austinjonathan1/EMS-for-StorageCells-in-EVs/Reports & Presentations/Midterm Report (EE 198B-01).docx

Midterm Report

By: Andrew Tran (012394096), Hiromi Saito (014065129), Jonathan Austin (012148162)

1. Accomplishments

a. Andrew:
  i. Revised the Bill of Materials for the Current Sense Module, to accommodate chip shortage
  ii. Helping Yun (a new member) get up to speed with OrCAD and basic knowledge of power module team
  iii. Assisted Hiromi in redesigning the PCB for the Current Sense Module
b. Hiromi:
  i. Resized the silkscreen layer to follow selected PCB manufacturer’s capabilities and to be practically visible
  ii. Readjusted pad connections on the high current components to be completely connected
  iii. Added via stitching to the larger planes on the current sense PCB to lower the impedance
  iv. Designated text boxes on the PCB file of the current sense to give viewers a better understanding of the different sections
  v. Removed/added inappropriate connections on the PCB file
c. Jonathan:
  i. Read through, watched video documentation, and presentations of the existing main DSP project work
  ii. Performed Lab Testing of existing DSP code on the existing hardware
  iii. Helped implement a matrix-based sorting algorithm from Professor Badawy’s paper, A Modular Multi-Level Converter for Energy Management of Hybrid Storage System in Electric Vehicles
    1. Wrote out the logic in a separate test code
    2. Helped integrate the logic into the existing main DSP code
  iv. Read through, watched video documentation, and presentations of the existing Linear Kalman Filter MATLAB work by Samuel

2. Plan

d. Andrew:
  i. Begin testing hardware once the PCB has been manufactured and assembled
  ii. Research how to use Altium for the next revision of the boards
  iii. Assist Yun for her upcoming work
e. Hiromi:
  i. Manufacture the current sense PCB and perform testing with the inverter PCB
    1. Record results and organize the data results into a report/presentation
  ii. Research how to use Altium
f. Jonathan:
  i. Continue understanding and researching the existing MATLAB work on the Linear Kalman Filter
  ii. Integrate it into Maryam’s Model Predictive Control MATLAB project
  iii. Document work in report and presentation

References

[1] S. S. George and M. O. Badawy, A Modular Multi-Level Converter for Energy Management of Hybrid Storage System in Electric Vehicles, 2018 IEEE Transportation Electrification Conference and Expo (ITEC), Long Beach, CA, USA, 2018, pp. 336-341, doi: 10.1109/ITEC.2018.8450237. Available at: <https://ieeexplore.ieee.org/abstract/document/8450237> [Accessed 14 March 2021].
