austinjonathan1/EMS-for-StorageCells-in-EVs/Reports & Presentations/SOC_Algorithm_Report.pdf

## SOC Algorithm Report

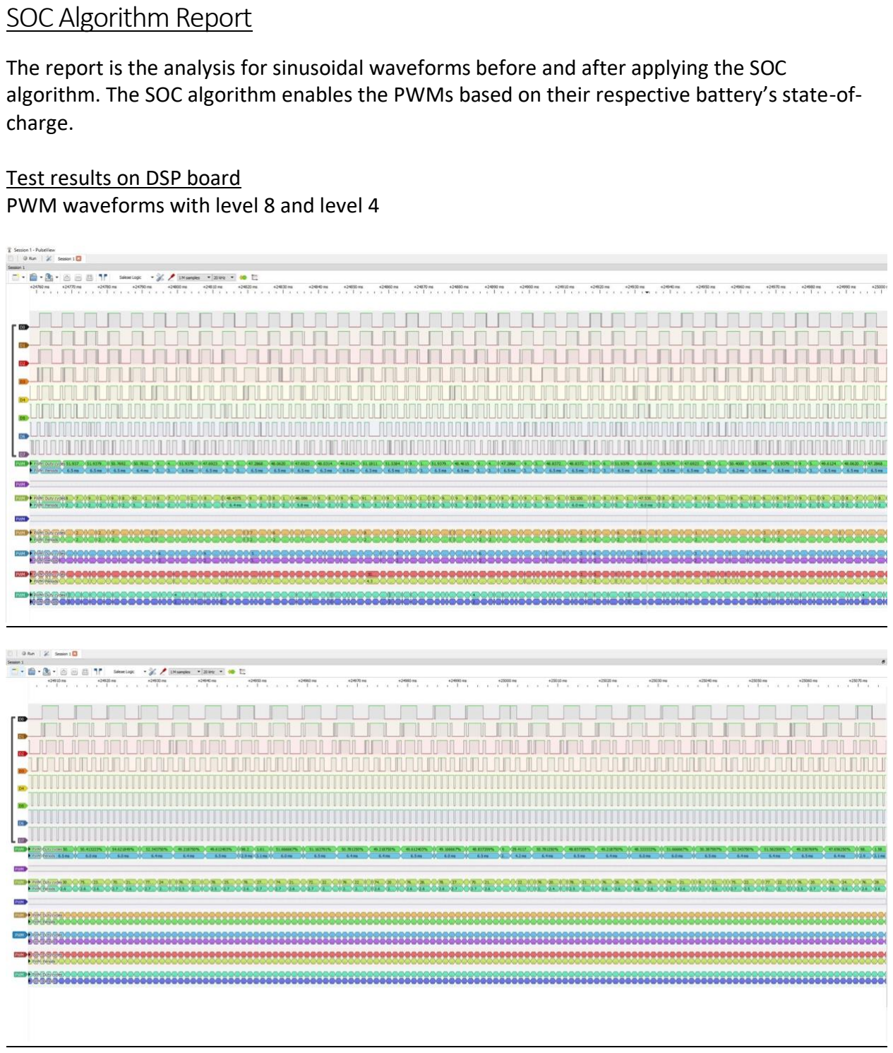
[picture p32: page 1]

The report is the analysis for sinusoidal waveforms before and after applying the SOC algorithm. The SOC algorithm enables the PWMs based on their respective battery’s state-ofcharge.

Test results on DSP board
PWM waveforms with level 8 and level 4

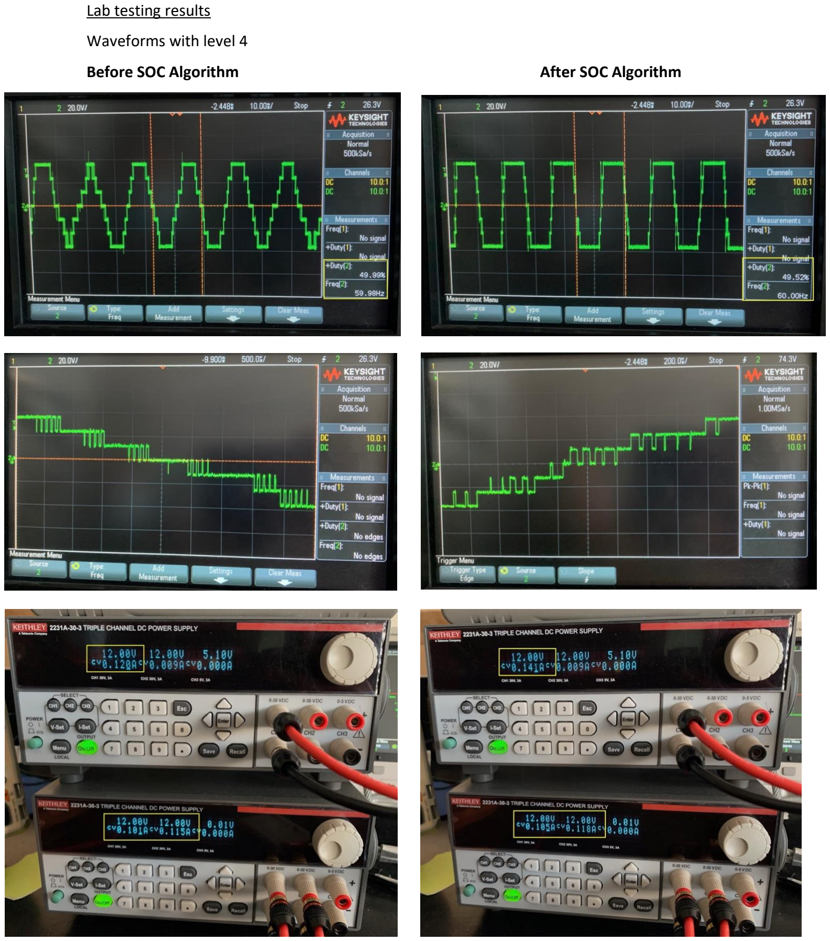
[picture p33: page 2]

Lab testing results

Waveforms with level 4

Before SOC Algorithm | After SOC Algorithm

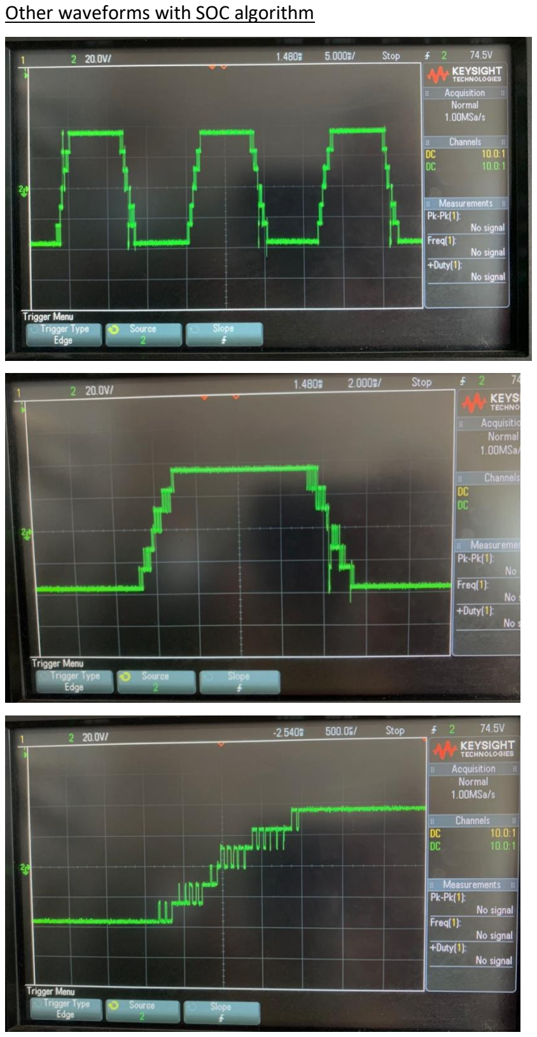
[picture p34: page 3]

Other waveforms with SOC algorithm

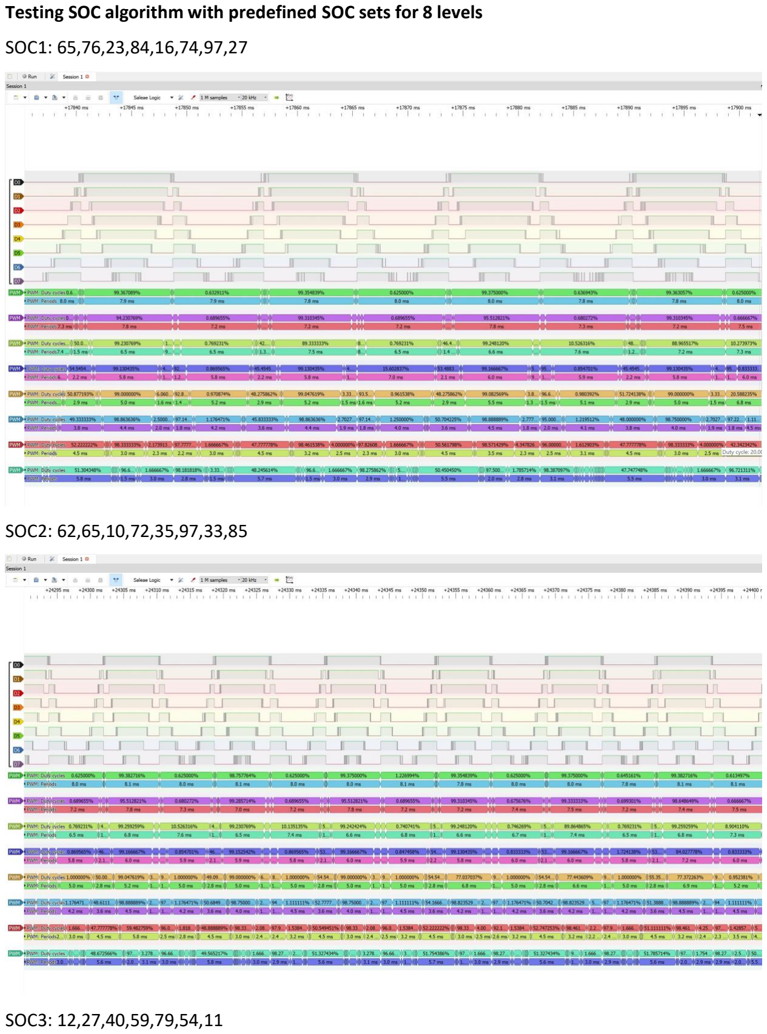
[picture p35: page 4]

Testing SOC algorithm with predefined SOC sets for 8 levels

SOC1: 65,76,23,84,16,74,97,27

SOC2: 62,65,10,72,35,97,33,85

SOC3: 12,27,40,59,79,54,11

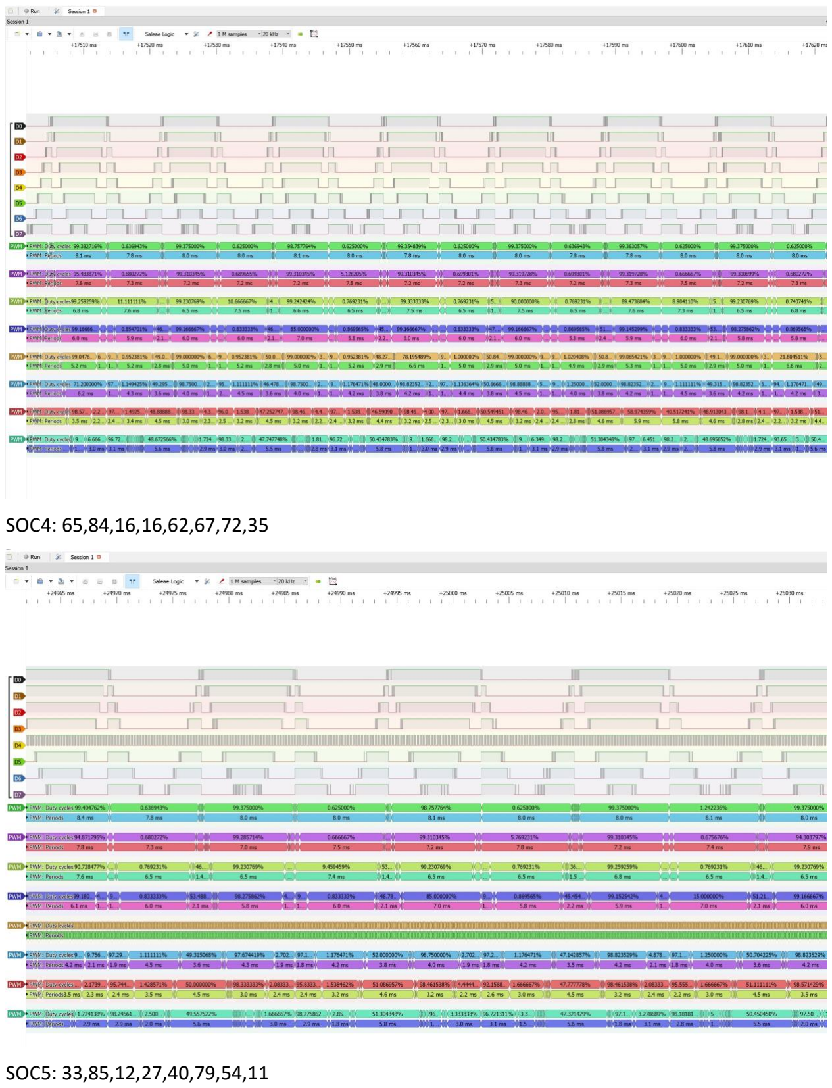
[picture p36: page 5]

SOC4: 65,84,16,16,62,67,72,35

SOC5: 33,85,12,27,40,79,54,11

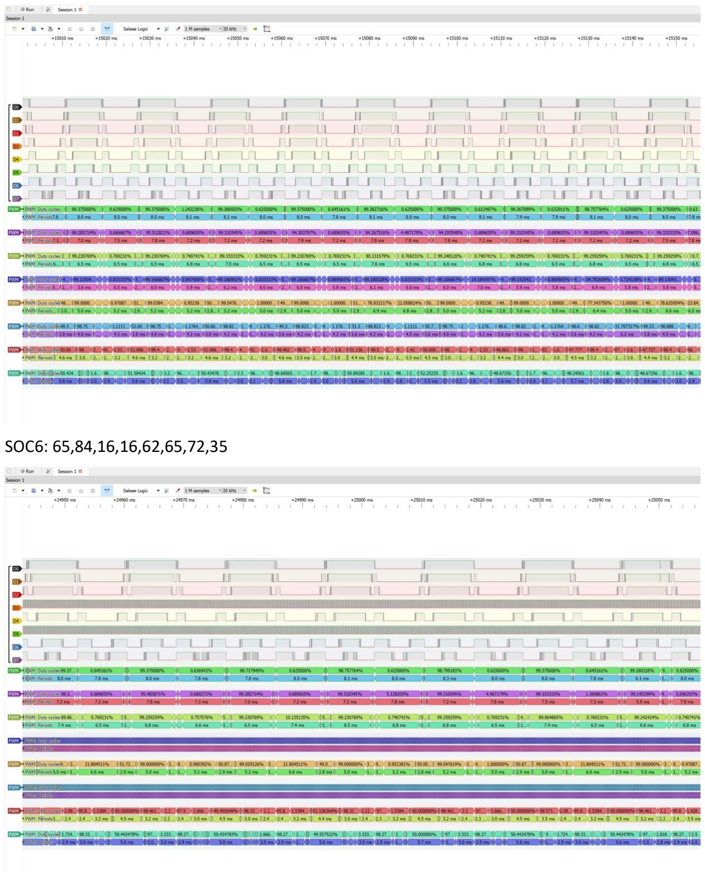
[picture p37: page 6]

SOC6: 65,84,16,16,62,65,72,35
