austinjonathan1/EMS-for-StorageCells-in-EVs/Reports & Presentations/EE198A Presentation Work Schedule (EE 198A-01).xlsx

Team | Member | Task | June |  |  |  |  | July
 |  |  | 2021-06-02 | 2021-06-09 | 2021-06-16 | 2021-06-23 | 2021-06-30 | 2021-07-05 | 2021-07-12 | 2021-07-19 | 2021-07-26
Embedded Systems (ES) | Jonathan | Finish Implementing and Testing SOC Sorting Algorithm
 |  | Write SOC Estimation Algorithm
Power Module Design (PMD) | Andrew | Learn Ansys
 | Hiromi | Redesign VIAs and footprints for Current Sense
 | Andrew & Hiromi | Learn more about designing PCBs on OrCad
 |  | Finish Current Sense PCB Board
