austinjonathan1/EMS-for-StorageCells-in-EVs/Reports & Presentations/Meeting Log File (EE 198A-01).xlsx

NOTE: All meetings lasted from 5:30 PM to 6:15PM
Team | 2021-02-01 | 2021-02-08 | 2021-02-15 | 2021-02-22 | 2021-03-01 | 2021-03-08 | 2021-03-15 | 2021-03-22 | 2021-03-29 | 2021-04-05 | 2021-04-12 | 2021-04-19 | 2021-04-26 | 2021-05-03 | 2021-05-10 | 2021-05-17
Embedded System (Jonathan Austin) | Research and learning (Badawy gave resources and content to read to understand the system) |  |  |  | Testing and validating existing code (presented results and planned further work at meetings) |  |  |  |  | Wrote, tested, and implemented code (presented results and consulted past members) |  |  |  | Badawy had family emergency so not a lot was done here besides creating presentations and writing reports
Power Module Design (Andrew Tran & Hiromi Saito) | Research and learning about the current system |  |  |  | Discussed the issues about different ground reference points came up with possible solutions |  | Finish designing current sense module and start using real components for simulation |  | Finalize current sense design Begin learning how to make a PCB | Presented current sense module schematic and simulation results Began working on PCB |  |  |  | Badawy had family emergency so not a lot was done here besides creating presentations and writing reports
