austinjonathan1/EMS-for-StorageCells-in-EVs/Reports & Presentations/Meeting Log File (EE 198B-01).xlsx

NOTE: All meetings lasted from 5:30 PM to 6:15PM
Spring 2021
Team | 2021-02-01 | 2021-02-08 | 2021-02-15 | 2021-02-22 | 2021-03-01 | 2021-03-08 | 2021-03-15 | 2021-03-22 | 2021-03-29 | 2021-04-05 | 2021-04-12 | 2021-04-19 | 2021-04-26 | 2021-05-03 | 2021-05-10 | 2021-05-17
Embedded System (Jonathan Austin) | Research and learning (Badawy gave resources and content to read to understand the system) |  |  |  | Testing and validating existing code (presented results and planned further work at meetings) |  |  |  |  | Wrote, tested, and implemented code (presented results and consulted past members) |  |  |  | Badawy had family emergency so not a lot was done here besides creating presentations and writing reports
Power Module Design (Andrew Tran & Hiromi Saito) | Research and learning about the current system |  |  |  | Discussed the issues about different ground reference points came up with possible solutions |  | Finish designing current sense module and start using real components for simulation |  | Finalize current sense design Begin learning how to make a PCB | Presented current sense module schematic and simulation results Began working on PCB |  |  |  | Badawy had family emergency so not a lot was done here besides creating presentations and writing reports
Fall 2021
Team | 2021-08-30 | 2021-09-06 | 2021-09-13 | 2021-09-20 | 2021-09-27 | 2021-10-04 | 2021-10-11 | 2021-10-18 | 2021-10-25 | 2021-11-01 | 2021-11-08 | 2021-11-15 | 2021-11-22 | 2021-11-29 | 2021-12-06
Embedded System (Jonathan Austin) | Finished up testing and tasks from pior semester |  | Research and learning (Badawy gave resources and content to read to understand the system) |  |  | Wrote and tested code (Based off academia and prior simulation work) |  |  |  | Lab testing (with implemented code) |  |  | Discussion with Badawy regarding report, presentation, and symposium poster
Power Module Design (Andrew Tran & Hiromi Saito) | Look over designs and figure out which components are out of stock and need to be replaced. |  |  | Re-simulate with new components and compare with the previous results to see if any design changes are necessary. |  | Redesign PCB, adjusting footprints, rerouting traces for manufacturing capabilities |  |  |  |  | Generate Gerbers to get quotes for board design and fixing any issues if necessary.
