austinjonathan1/EMS-for-StorageCells-in-EVs/(list of files, cad)

Other CAD files:
Optimized_MMC_PWM/Debug/custom_drivers/adc_ISR.obj
Optimized_MMC_PWM/Debug/driverlib/can.obj
Optimized_MMC_PWM/Debug/custom_drivers/adc_input.obj
Optimized_MMC_PWM/Debug/driverlib/memcfg.obj
Optimized_MMC_PWM/Debug/custom_drivers/pwm_driver.obj
Optimized_MMC_PWM/Debug/driverlib/cmpss.obj
Optimized_MMC_PWM/Debug/custom_drivers/optimized_pwm_driver.obj
Optimized_MMC_PWM/Debug/driverlib/cla.obj
Optimized_MMC_PWM/Debug/custom_drivers/adc_driver.obj
Optimized_MMC_PWM/Debug/driverlib/dac.obj
Optimized_MMC_PWM/Debug/driverlib/i2c.obj
Optimized_MMC_PWM/Debug/driverlib/hrpwm.obj
Optimized_MMC_PWM/Debug/driverlib/eqep.obj
Optimized_MMC_PWM/Debug/driverlib/emif.obj
Optimized_MMC_PWM/Debug/driverlib/dma.obj
Optimized_MMC_PWM/Debug/driverlib/interrupt.obj
Optimized_MMC_PWM/Debug/driverlib/cputimer.obj
Optimized_MMC_PWM/Debug/driverlib/ecap.obj
Optimized_MMC_PWM/Debug/driverlib/asysctl.obj
Optimized_MMC_PWM/Debug/driverlib/adc.obj
Optimized_MMC_PWM/Debug/driverlib/mcbsp.obj
Optimized_MMC_PWM/Debug/driverlib/gpio.obj
Optimized_MMC_PWM/Debug/driverlib/epwm.obj
Optimized_MMC_PWM/Debug/driverlib/dcsm.obj
Optimized_MMC_PWM/Debug/driverlib/flash.obj
