austinjonathan1/EMS-for-StorageCells-in-EVs/MMC DSP Interface/MMC_DSP_interface.brd

## EAGLE design MMC DSP Interface/MMC_DSP_interface.brd (2023-10-27)

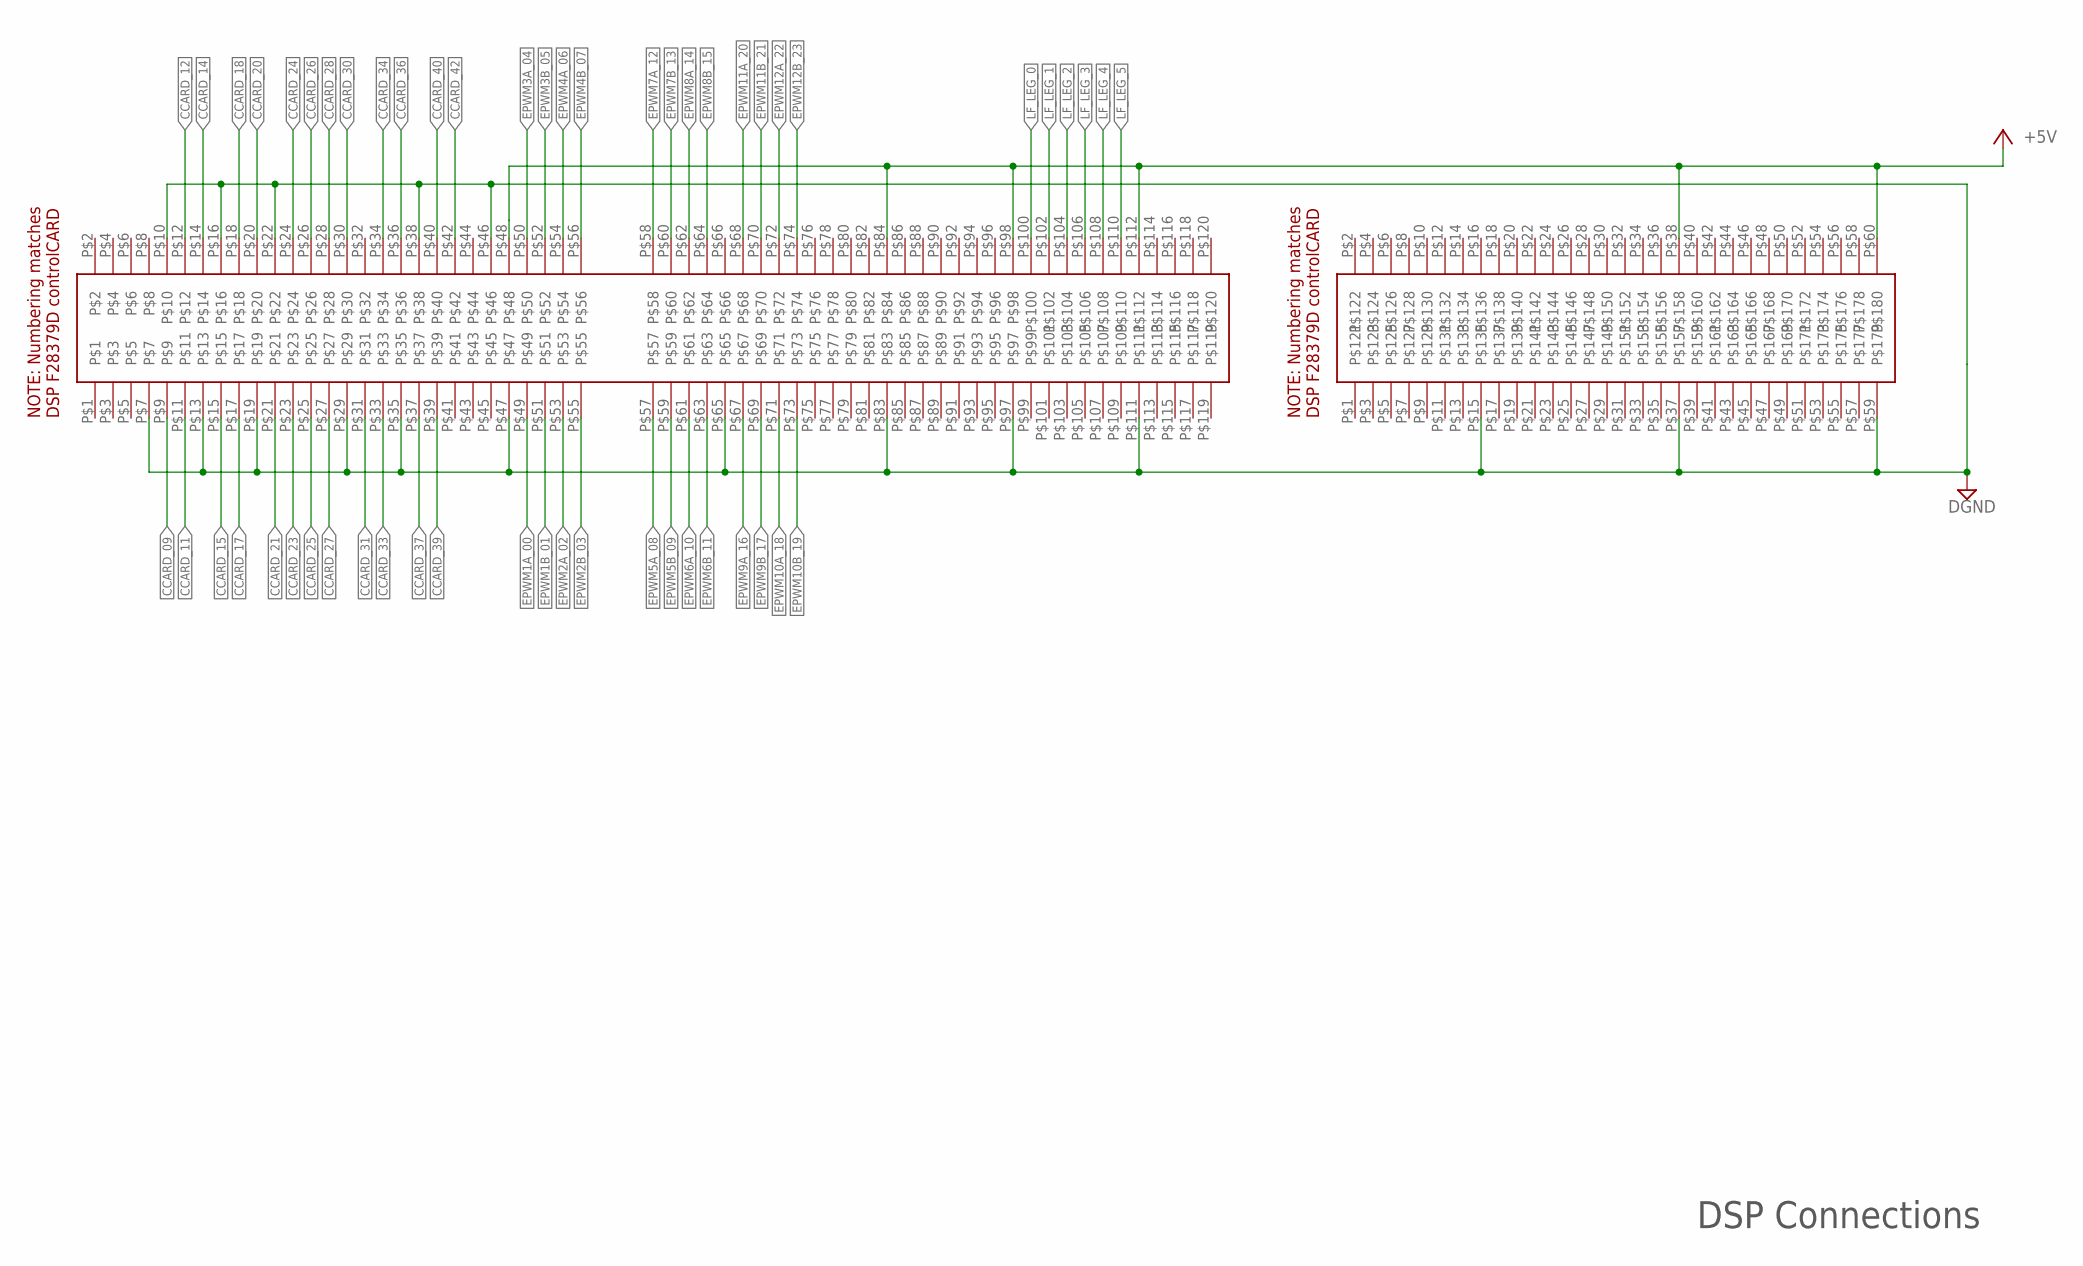
[picture p38: schematic MMC_DSP_interface.sch, sheet 1, DSP Connections]

Parts:
U$1: HSEC8-160-01-L-DV-A-BL
U$2: HSEC8-130-01-SM-DV-A

Connections:
+5V: U$1.P$48, U$1.P$84, U$1.P$98, U$1.P$112, U$2.P$38, U$2.P$60; also elsewhere on the board
CCARD_09: U$1.P$9; also elsewhere on the board
CCARD_11: U$1.P$11; also elsewhere on the board
CCARD_12: U$1.P$12; also elsewhere on the board
CCARD_14: U$1.P$14; also elsewhere on the board
CCARD_15: U$1.P$15; also elsewhere on the board
CCARD_17: U$1.P$17; also elsewhere on the board
CCARD_18: U$1.P$18; also elsewhere on the board
CCARD_20: U$1.P$20; also elsewhere on the board
CCARD_21: U$1.P$21; also elsewhere on the board
CCARD_23: U$1.P$23; also elsewhere on the board
CCARD_24: U$1.P$24; also elsewhere on the board
CCARD_25: U$1.P$25; also elsewhere on the board
CCARD_26: U$1.P$26; also elsewhere on the board
CCARD_27: U$1.P$27; also elsewhere on the board
CCARD_28: U$1.P$28; also elsewhere on the board
CCARD_30: U$1.P$30; also elsewhere on the board
CCARD_31: U$1.P$31; also elsewhere on the board
CCARD_33: U$1.P$33; also elsewhere on the board
CCARD_34: U$1.P$34; also elsewhere on the board
CCARD_36: U$1.P$36; also elsewhere on the board
CCARD_37: U$1.P$37; also elsewhere on the board
CCARD_39: U$1.P$39; also elsewhere on the board
CCARD_40: U$1.P$40; also elsewhere on the board
CCARD_42: U$1.P$42; also elsewhere on the board
DGND: U$1.P$7, U$1.P$10, U$1.P$13, U$1.P$16, U$1.P$19, U$1.P$22, U$1.P$29, U$1.P$35, U$1.P$38, U$1.P$46, U$1.P$47, U$1.P$65, U$1.P$83, U$1.P$97, U$1.P$111, U$2.P$15, U$2.P$37, U$2.P$59; also elsewhere on the board
EPWM1A_00: U$1.P$49; also elsewhere on the board
EPWM1B_01: U$1.P$51; also elsewhere on the board
EPWM2A_02: U$1.P$53; also elsewhere on the board
EPWM2B_03: U$1.P$55; also elsewhere on the board
EPWM3A_04: U$1.P$50; also elsewhere on the board
EPWM3B_05: U$1.P$52; also elsewhere on the board
EPWM4A_06: U$1.P$54; also elsewhere on the board
EPWM4B_07: U$1.P$56; also elsewhere on the board
EPWM5A_08: U$1.P$57; also elsewhere on the board
EPWM5B_09: U$1.P$59; also elsewhere on the board
EPWM6A_10: U$1.P$61; also elsewhere on the board
EPWM6B_11: U$1.P$63; also elsewhere on the board
EPWM7A_12: U$1.P$58; also elsewhere on the board
EPWM7B_13: U$1.P$60; also elsewhere on the board
EPWM8A_14: U$1.P$62; also elsewhere on the board
EPWM8B_15: U$1.P$64; also elsewhere on the board
EPWM9A_16: U$1.P$67; also elsewhere on the board
EPWM9B_17: U$1.P$69; also elsewhere on the board
EPWM10A_18: U$1.P$71; also elsewhere on the board
EPWM10B_19: U$1.P$73; also elsewhere on the board
EPWM11A_20: U$1.P$68; also elsewhere on the board
EPWM11B_21: U$1.P$70; also elsewhere on the board
EPWM12A_22: U$1.P$72; also elsewhere on the board
EPWM12B_23: U$1.P$74; also elsewhere on the board
LF_LEG_0: U$1.P$100; also elsewhere on the board
LF_LEG_1: U$1.P$102; also elsewhere on the board
LF_LEG_2: U$1.P$104; also elsewhere on the board
LF_LEG_3: U$1.P$106; also elsewhere on the board
LF_LEG_4: U$1.P$108; also elsewhere on the board
LF_LEG_5: U$1.P$110; also elsewhere on the board

Notes on the sheet:
DSP Connections

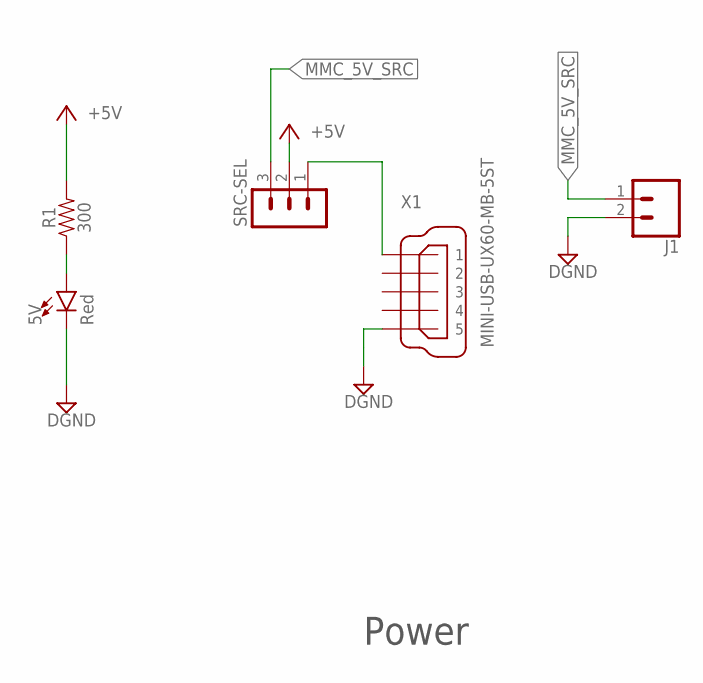
[picture p39: schematic MMC_DSP_interface.sch, sheet 2, Power]

Parts:
5V: Red; LED-0603
J1: CONN_02; 1X02
R1: 300; 0603
SRC-SEL: MA03-1
X1: MINI-USB-UX60-MB-5ST; UX60-MB-5ST

Connections:
+5V: R1.2, SRC-SEL.2; also elsewhere on the board
DGND: 5V.C, J1.2, X1.5; also elsewhere on the board
MMC_5V_SRC: J1.1, SRC-SEL.3
unnamed: SRC-SEL.1, X1.1
unnamed: 5V.A, R1.1

Notes on the sheet:
Power

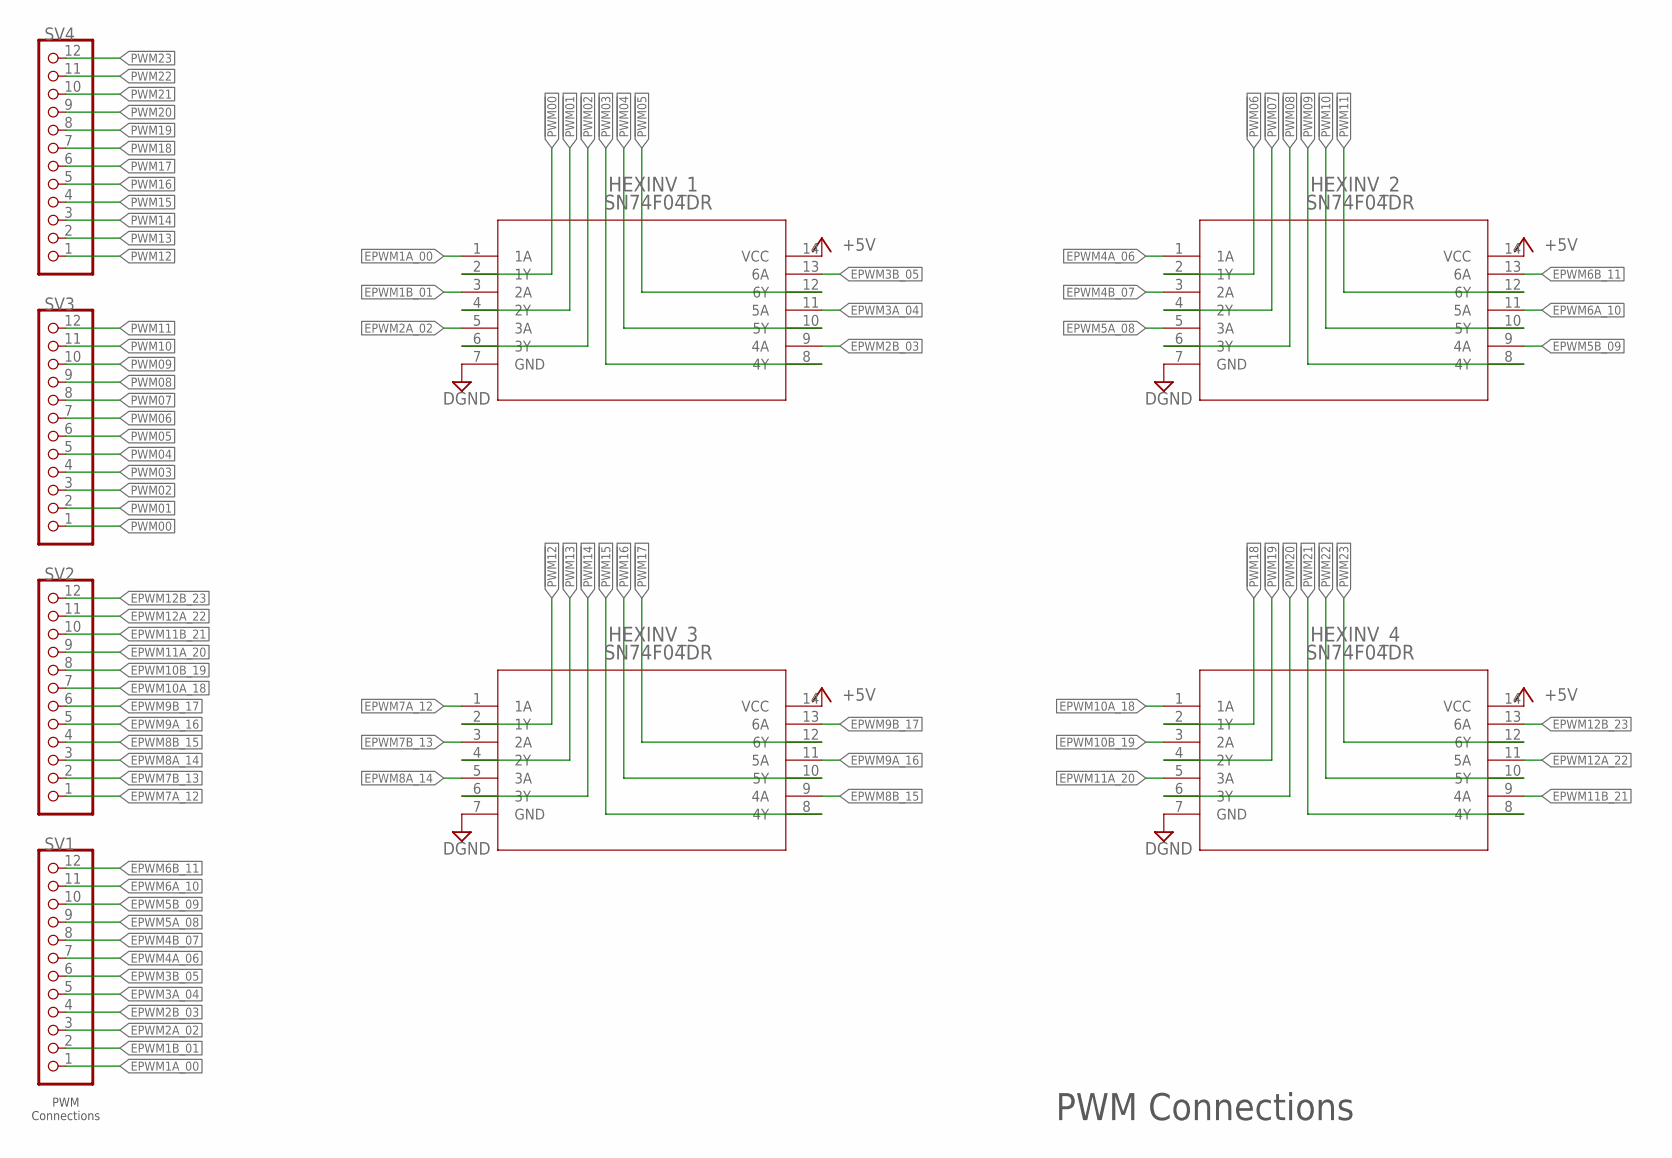
[picture p40: schematic MMC_DSP_interface.sch, sheet 3, PWM Connections]

Parts:
HEXINV_1, HEXINV_2, HEXINV_3, HEXINV_4: SN74F04DR; D14
SV1, SV2, SV3, SV4: PINHD-1X12-CB; 1X12-CB

Connections:
!PWM00: HEXINV_1.2 (1Y), SV3.1
!PWM01: HEXINV_1.4 (2Y), SV3.2
!PWM02: HEXINV_1.6 (3Y), SV3.3
!PWM03: HEXINV_1.8 (4Y), SV3.4
!PWM04: HEXINV_1.10 (5Y), SV3.5
!PWM05: HEXINV_1.12 (6Y), SV3.6
!PWM06: HEXINV_2.2 (1Y), SV3.7
!PWM07: HEXINV_2.4 (2Y), SV3.8
!PWM08: HEXINV_2.6 (3Y), SV3.9
!PWM09: HEXINV_2.8 (4Y), SV3.10
!PWM10: HEXINV_2.10 (5Y), SV3.11
!PWM11: HEXINV_2.12 (6Y), SV3.12
!PWM12: HEXINV_3.2 (1Y), SV4.1
!PWM13: HEXINV_3.4 (2Y), SV4.2
!PWM14: HEXINV_3.6 (3Y), SV4.3
!PWM15: HEXINV_3.8 (4Y), SV4.4
!PWM16: HEXINV_3.10 (5Y), SV4.5
!PWM17: HEXINV_3.12 (6Y), SV4.6
!PWM18: HEXINV_4.2 (1Y), SV4.7
!PWM19: HEXINV_4.4 (2Y), SV4.8
!PWM20: HEXINV_4.6 (3Y), SV4.9
!PWM21: HEXINV_4.8 (4Y), SV4.10
!PWM22: HEXINV_4.10 (5Y), SV4.11
!PWM23: HEXINV_4.12 (6Y), SV4.12
+5V: HEXINV_1.14 (VCC), HEXINV_2.14 (VCC), HEXINV_3.14 (VCC), HEXINV_4.14 (VCC); also elsewhere on the board
DGND: HEXINV_1.7 (GND), HEXINV_2.7 (GND), HEXINV_3.7 (GND), HEXINV_4.7 (GND); also elsewhere on the board
EPWM1A_00: HEXINV_1.1 (1A), SV1.1; also elsewhere on the board
EPWM1B_01: HEXINV_1.3 (2A), SV1.2; also elsewhere on the board
EPWM2A_02: HEXINV_1.5 (3A), SV1.3; also elsewhere on the board
EPWM2B_03: HEXINV_1.9 (4A), SV1.4; also elsewhere on the board
EPWM3A_04: HEXINV_1.11 (5A), SV1.5; also elsewhere on the board
EPWM3B_05: HEXINV_1.13 (6A), SV1.6; also elsewhere on the board
EPWM4A_06: HEXINV_2.1 (1A), SV1.7; also elsewhere on the board
EPWM4B_07: HEXINV_2.3 (2A), SV1.8; also elsewhere on the board
EPWM5A_08: HEXINV_2.5 (3A), SV1.9; also elsewhere on the board
EPWM5B_09: HEXINV_2.9 (4A), SV1.10; also elsewhere on the board
EPWM6A_10: HEXINV_2.11 (5A), SV1.11; also elsewhere on the board
EPWM6B_11: HEXINV_2.13 (6A), SV1.12; also elsewhere on the board
EPWM7A_12: HEXINV_3.1 (1A), SV2.1; also elsewhere on the board
EPWM7B_13: HEXINV_3.3 (2A), SV2.2; also elsewhere on the board
EPWM8A_14: HEXINV_3.5 (3A), SV2.3; also elsewhere on the board
EPWM8B_15: HEXINV_3.9 (4A), SV2.4; also elsewhere on the board
EPWM9A_16: HEXINV_3.11 (5A), SV2.5; also elsewhere on the board
EPWM9B_17: HEXINV_3.13 (6A), SV2.6; also elsewhere on the board
EPWM10A_18: HEXINV_4.1 (1A), SV2.7; also elsewhere on the board
EPWM10B_19: HEXINV_4.3 (2A), SV2.8; also elsewhere on the board
EPWM11A_20: HEXINV_4.5 (3A), SV2.9; also elsewhere on the board
EPWM11B_21: HEXINV_4.9 (4A), SV2.10; also elsewhere on the board
EPWM12A_22: HEXINV_4.11 (5A), SV2.11; also elsewhere on the board
EPWM12B_23: HEXINV_4.13 (6A), SV2.12; also elsewhere on the board

Notes on the sheet:
PWM Connections
PWM Connections

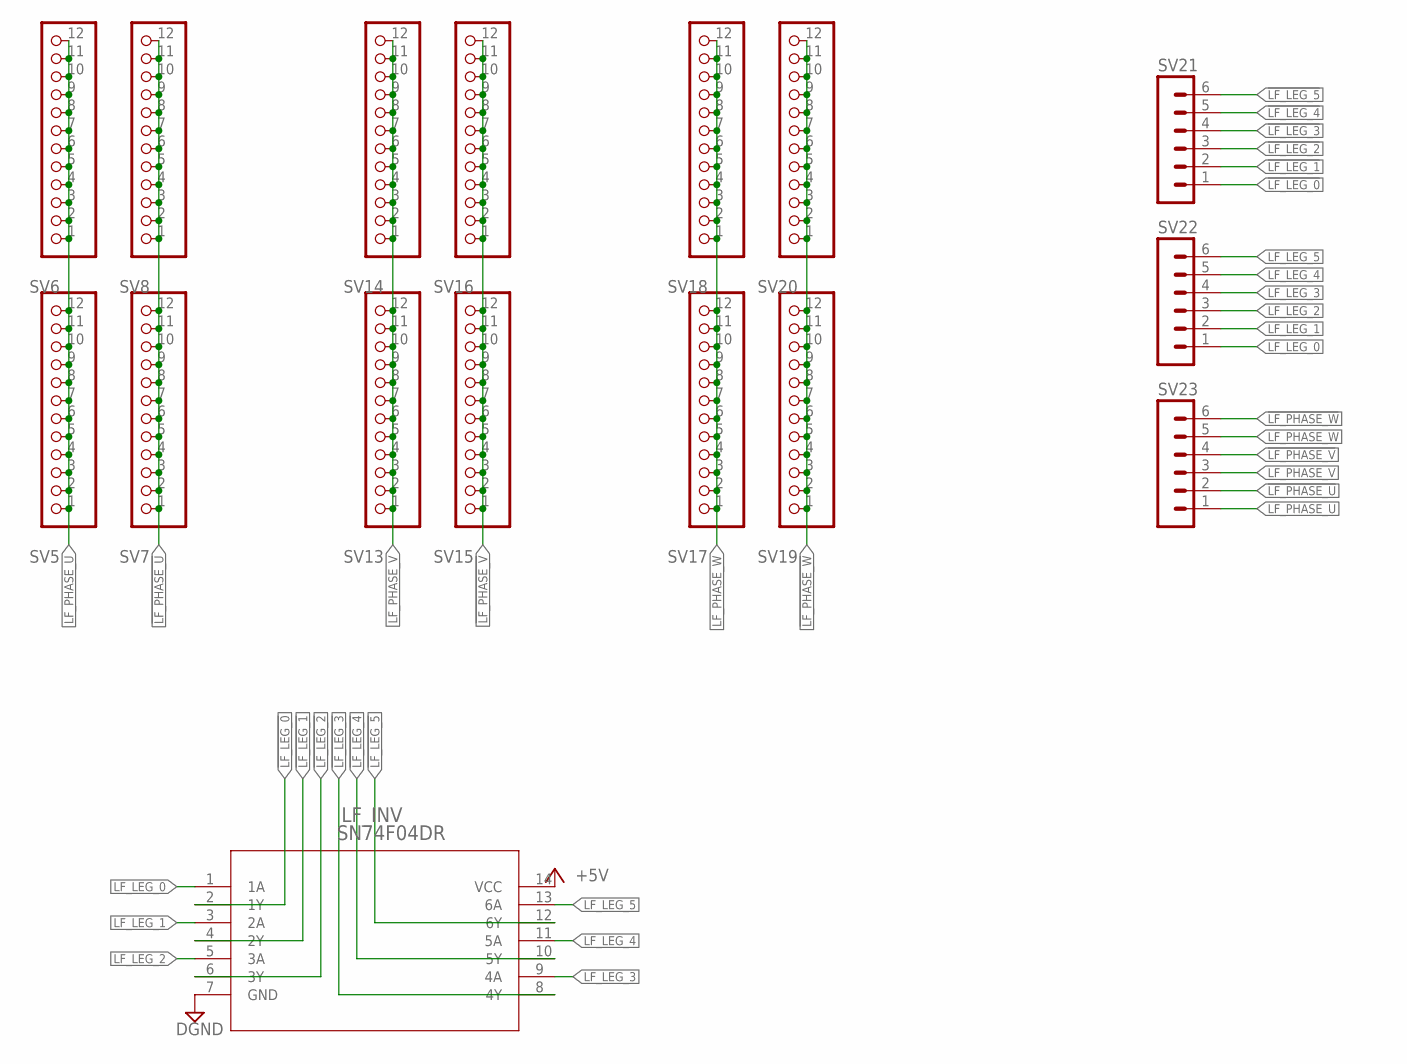
[picture p41: schematic MMC_DSP_interface.sch, sheet 4, GPIO NOT gates]

Parts:
LF_INV: SN74F04DR; D14
SV5, SV6, SV7, SV8, SV13, SV14, SV15, SV16, SV17, SV18, SV19, SV20: PINHD-1X12-CB; 1X12-CB
SV21, SV22, SV23: MA06-1

Connections:
!LF_LEG_0: LF_INV.2 (1Y), SV21.1
!LF_LEG_1: LF_INV.4 (2Y), SV21.2
!LF_LEG_2: LF_INV.6 (3Y), SV21.3
!LF_LEG_3: LF_INV.8 (4Y), SV21.4
!LF_LEG_4: LF_INV.10 (5Y), SV21.5
!LF_LEG_5: LF_INV.12 (6Y), SV21.6
!LF_PHASE_U: SV7.1, SV7.2, SV7.3, SV7.4, SV7.5, SV7.6, SV7.7, SV7.8, SV7.9, SV7.10, SV7.11, SV7.12, SV8.1, SV8.2, SV8.3, SV8.4, SV8.5, SV8.6, SV8.7, SV8.8, SV8.9, SV8.10, SV8.11, SV8.12, SV23.2
!LF_PHASE_V: SV15.1, SV15.2, SV15.3, SV15.4, SV15.5, SV15.6, SV15.7, SV15.8, SV15.9, SV15.10, SV15.11, SV15.12, SV16.1, SV16.2, SV16.3, SV16.4, SV16.5, SV16.6, SV16.7, SV16.8, SV16.9, SV16.10, SV16.11, SV16.12, SV23.4
!LF_PHASE_W: SV19.1, SV19.2, SV19.3, SV19.4, SV19.5, SV19.6, SV19.7, SV19.8, SV19.9, SV19.10, SV19.11, SV19.12, SV20.1, SV20.2, SV20.3, SV20.4, SV20.5, SV20.6, SV20.7, SV20.8, SV20.9, SV20.10, SV20.11, SV20.12, SV23.6
+5V: LF_INV.14 (VCC); also elsewhere on the board
DGND: LF_INV.7 (GND); also elsewhere on the board
LF_LEG_0: LF_INV.1 (1A), SV22.1; also elsewhere on the board
LF_LEG_1: LF_INV.3 (2A), SV22.2; also elsewhere on the board
LF_LEG_2: LF_INV.5 (3A), SV22.3; also elsewhere on the board
LF_LEG_3: LF_INV.9 (4A), SV22.4; also elsewhere on the board
LF_LEG_4: LF_INV.11 (5A), SV22.5; also elsewhere on the board
LF_LEG_5: LF_INV.13 (6A), SV22.6; also elsewhere on the board
LF_PHASE_U: SV5.1, SV5.2, SV5.3, SV5.4, SV5.5, SV5.6, SV5.7, SV5.8, SV5.9, SV5.10, SV5.11, SV5.12, SV6.1, SV6.2, SV6.3, SV6.4, SV6.5, SV6.6, SV6.7, SV6.8, SV6.9, SV6.10, SV6.11, SV6.12, SV23.1
LF_PHASE_V: SV13.1, SV13.2, SV13.3, SV13.4, SV13.5, SV13.6, SV13.7, SV13.8, SV13.9, SV13.10, SV13.11, SV13.12, SV14.1, SV14.2, SV14.3, SV14.4, SV14.5, SV14.6, SV14.7, SV14.8, SV14.9, SV14.10, SV14.11, SV14.12, SV23.3
LF_PHASE_W: SV17.1, SV17.2, SV17.3, SV17.4, SV17.5, SV17.6, SV17.7, SV17.8, SV17.9, SV17.10, SV17.11, SV17.12, SV18.1, SV18.2, SV18.3, SV18.4, SV18.5, SV18.6, SV18.7, SV18.8, SV18.9, SV18.10, SV18.11, SV18.12, SV23.5

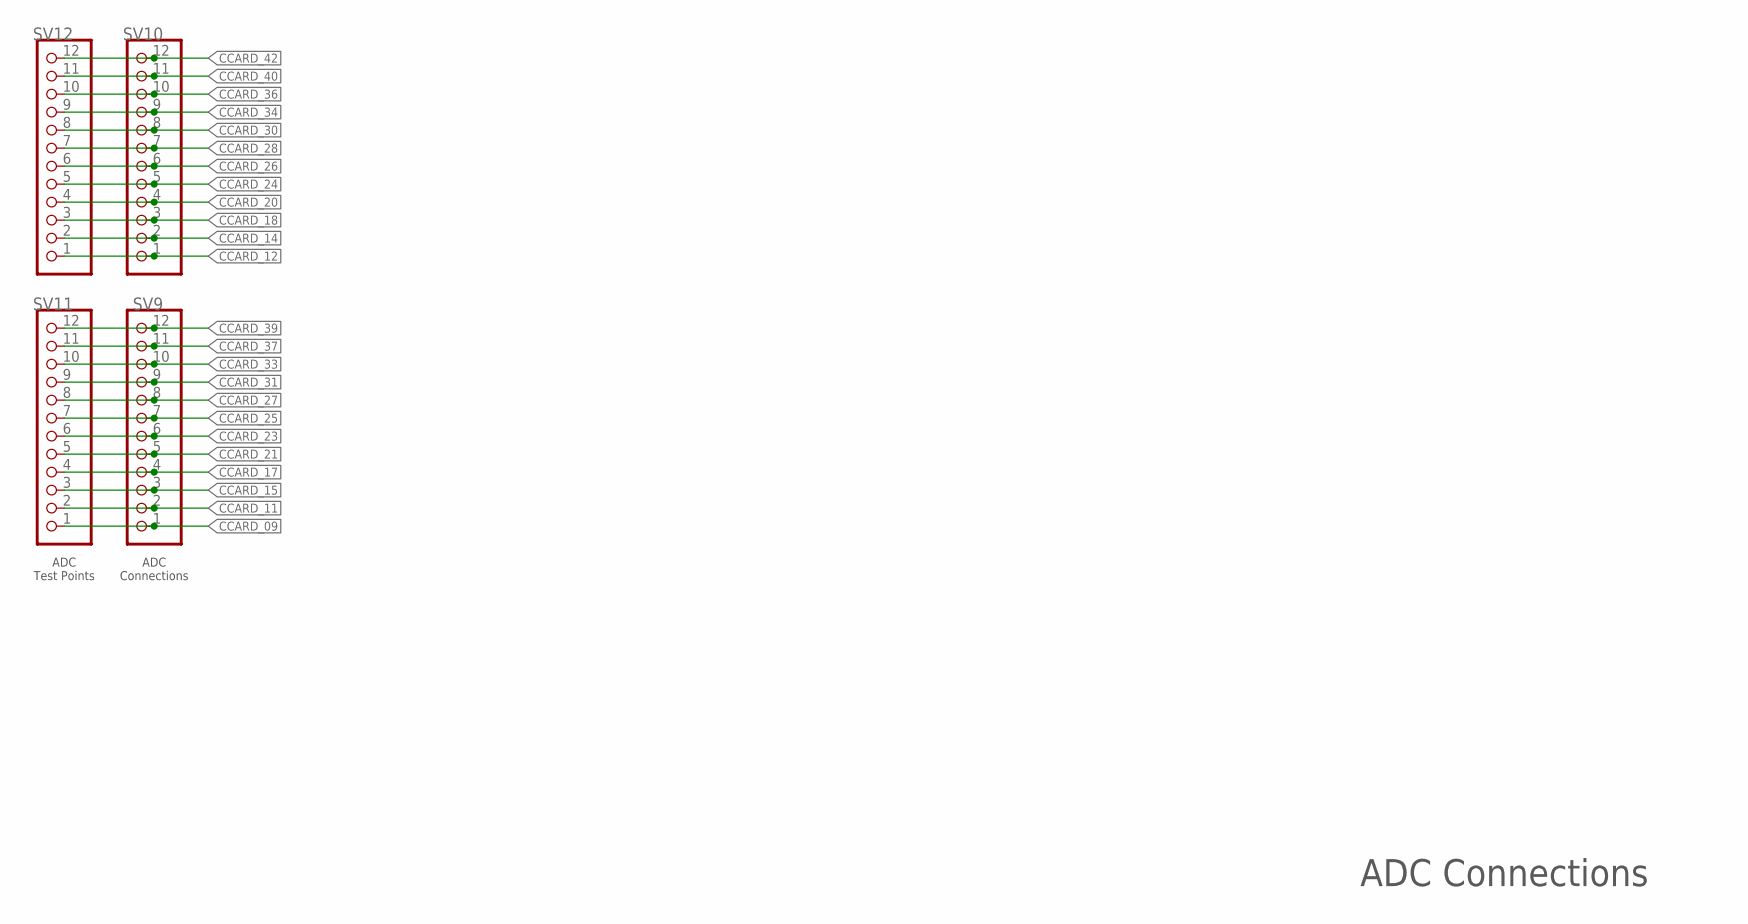
[picture p42: schematic MMC_DSP_interface.sch, sheet 5, Analog Connections]

Parts:
SV9, SV10, SV11, SV12: PINHD-1X12-CB; 1X12-CB

Connections:
CCARD_09: SV9.1, SV11.1; also elsewhere on the board
CCARD_11: SV9.2, SV11.2; also elsewhere on the board
CCARD_12: SV10.1, SV12.1; also elsewhere on the board
CCARD_14: SV10.2, SV12.2; also elsewhere on the board
CCARD_15: SV9.3, SV11.3; also elsewhere on the board
CCARD_17: SV9.4, SV11.4; also elsewhere on the board
CCARD_18: SV10.3, SV12.3; also elsewhere on the board
CCARD_20: SV10.4, SV12.4; also elsewhere on the board
CCARD_21: SV9.5, SV11.5; also elsewhere on the board
CCARD_23: SV9.6, SV11.6; also elsewhere on the board
CCARD_24: SV10.5, SV12.5; also elsewhere on the board
CCARD_25: SV9.7, SV11.7; also elsewhere on the board
CCARD_26: SV10.6, SV12.6; also elsewhere on the board
CCARD_27: SV9.8, SV11.8; also elsewhere on the board
CCARD_28: SV10.7, SV12.7; also elsewhere on the board
CCARD_30: SV10.8, SV12.8; also elsewhere on the board
CCARD_31: SV9.9, SV11.9; also elsewhere on the board
CCARD_33: SV9.10, SV11.10; also elsewhere on the board
CCARD_34: SV10.9, SV12.9; also elsewhere on the board
CCARD_36: SV10.10, SV12.10; also elsewhere on the board
CCARD_37: SV9.11, SV11.11; also elsewhere on the board
CCARD_39: SV9.12, SV11.12; also elsewhere on the board
CCARD_40: SV10.11, SV12.11; also elsewhere on the board
CCARD_42: SV10.12, SV12.12; also elsewhere on the board

Notes on the sheet:
ADC Connections
ADC Connections
ADC Test Points

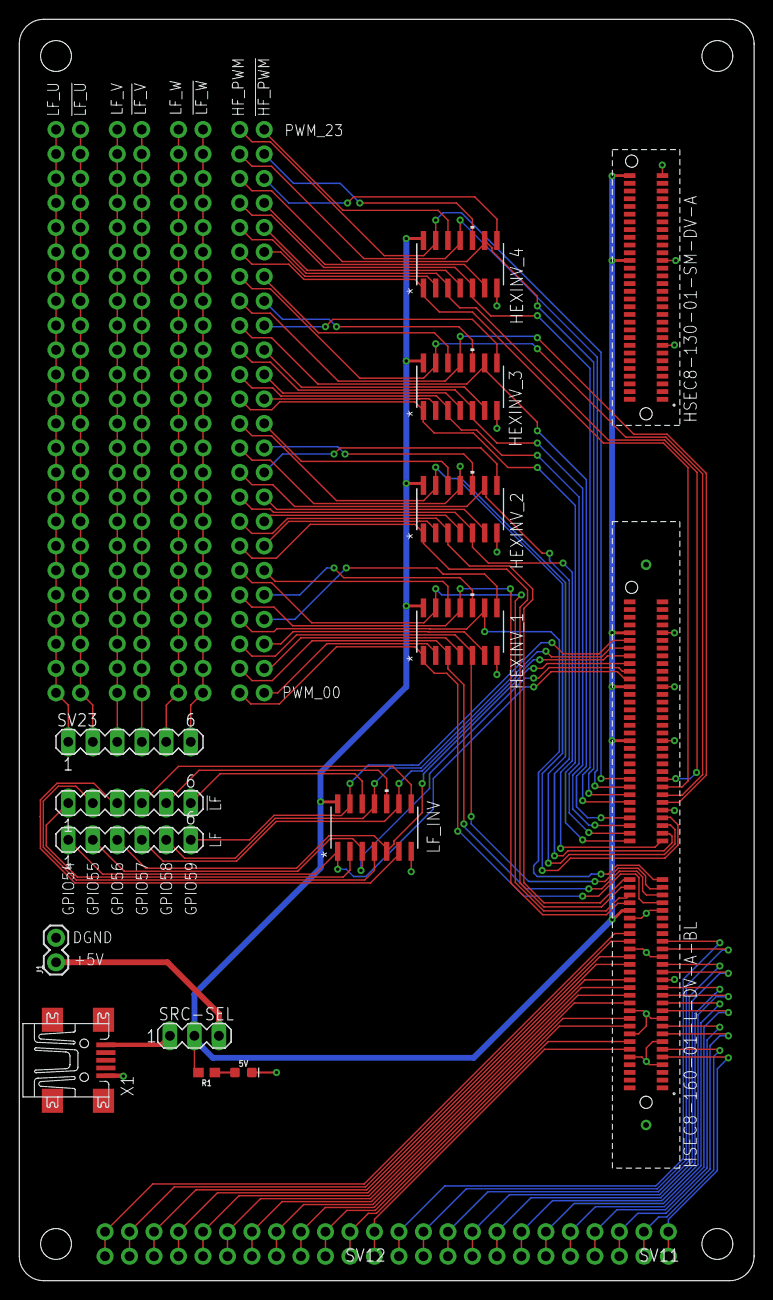
[picture p43: board MMC_DSP_interface.brd from above]

Board: 2 copper layers, 76.2 x 130.8 mm, 35 parts (0 on the bottom side), 95 nets.
